OpHaCo/smart_coffee_machine/hardware/scope_capture/brew_button_press_falling_edge.png

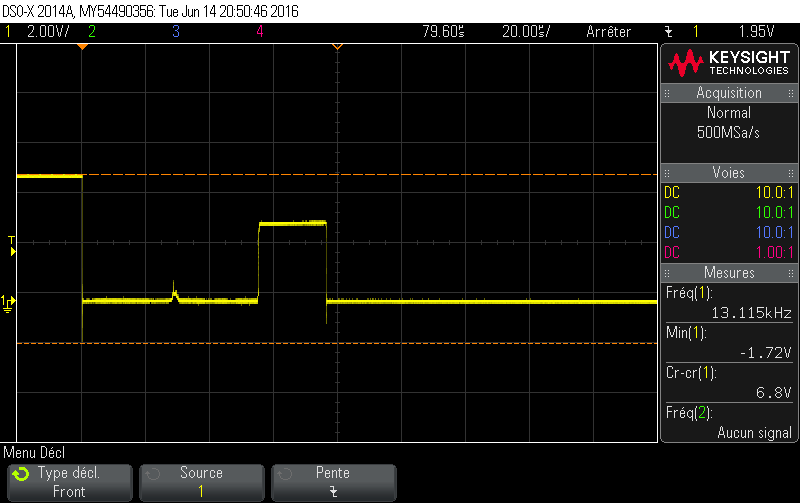
hardware/scope_capture/brew_button_press_falling_edge.png
