OpHaCo/smart_coffee_machine/hardware/scope_capture/brew_button_press_full.png

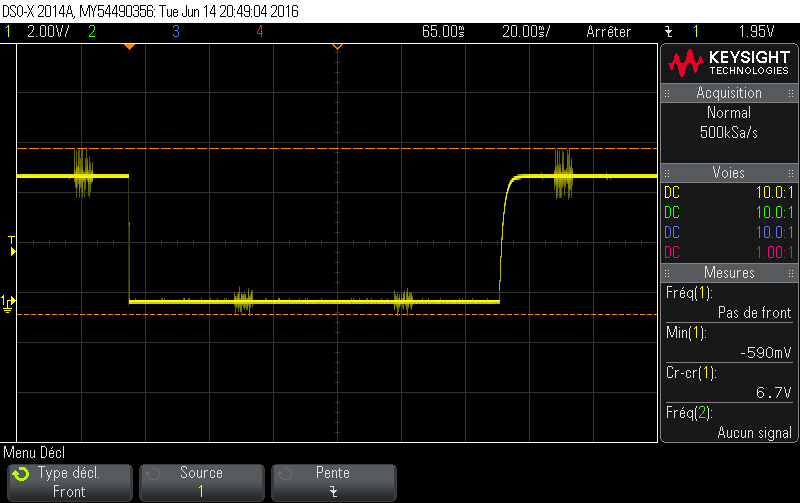
hardware/scope_capture/brew_button_press_full.png
