OpHaCo/smart_coffee_machine/hardware/scope_capture/small_cup_press_full.png

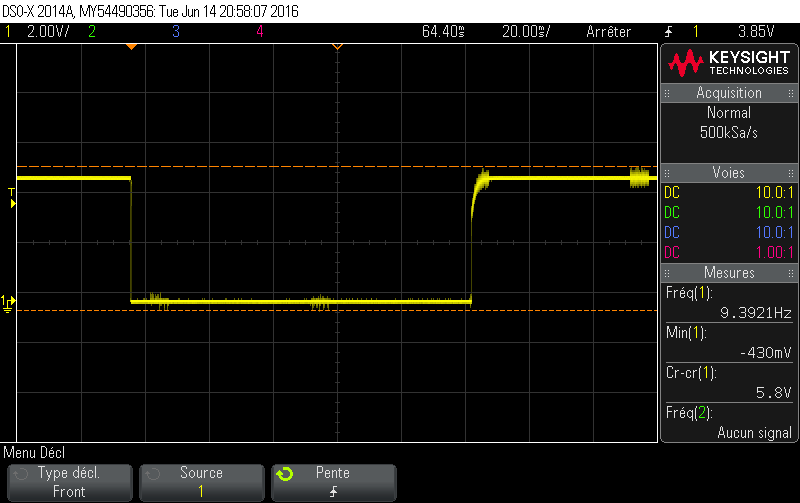
hardware/scope_capture/small_cup_press_full.png
