OpHaCo/smart_coffee_machine/hardware/scope_capture/small_cup_press_rising_edge.png

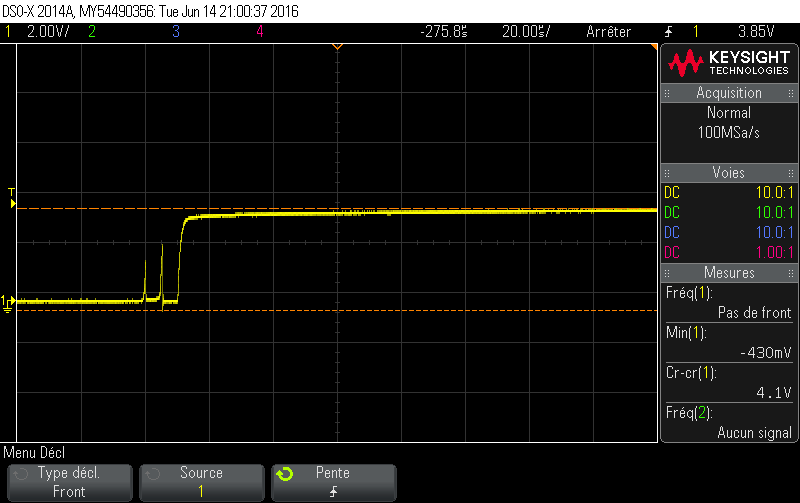
hardware/scope_capture/small_cup_press_rising_edge.png
