OpHaCo/smart_coffee_machine/img/front_panel_daughter_board.jpg

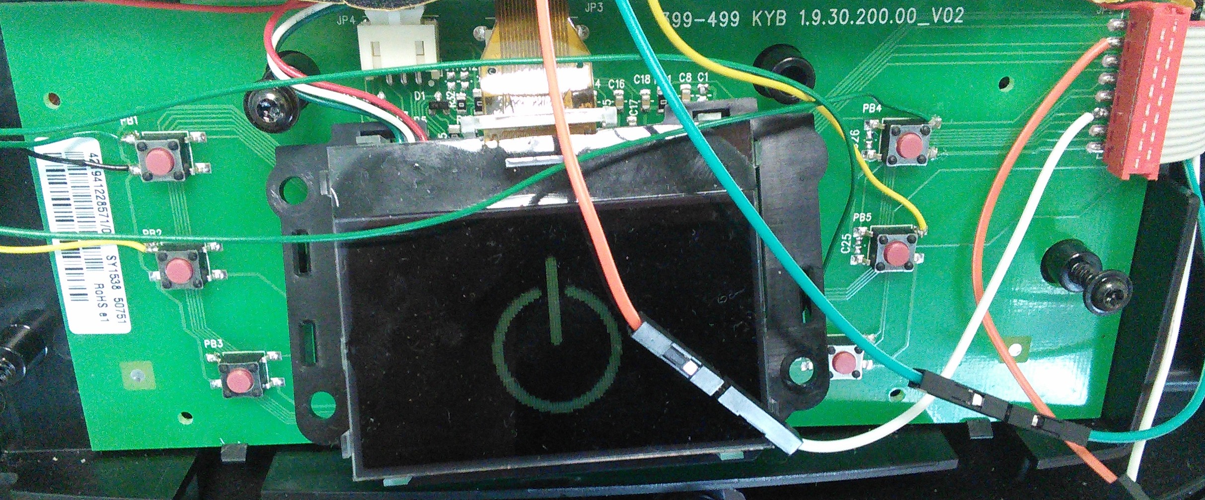
img/front_panel_daughter_board.jpg
