OpHaCo/smart_coffee_machine/img/saeco.jpg

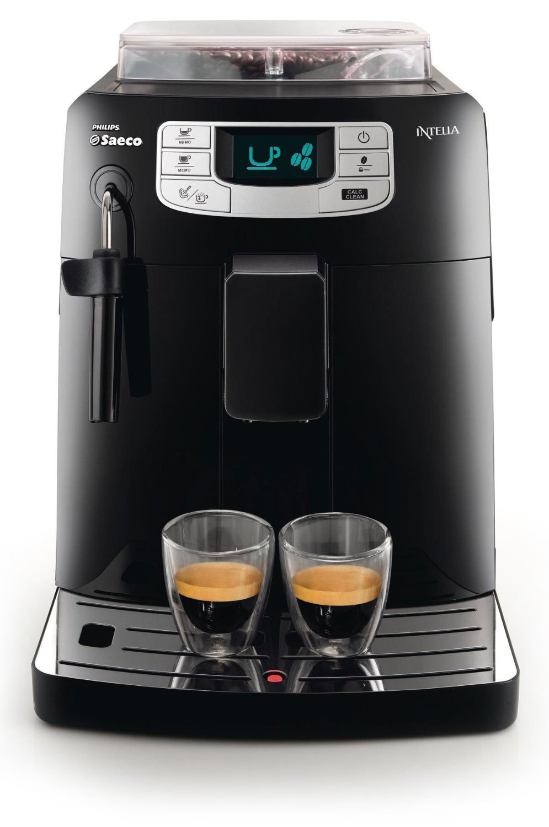
img/saeco.jpg
