OpHaCo/smart_coffee_machine/hardware/pcb_design/smart_coffee_hack.kicad_pcb

## KiCad design hardware/pcb_design/smart_coffee_hack.kicad_pcb (2016-07-22)

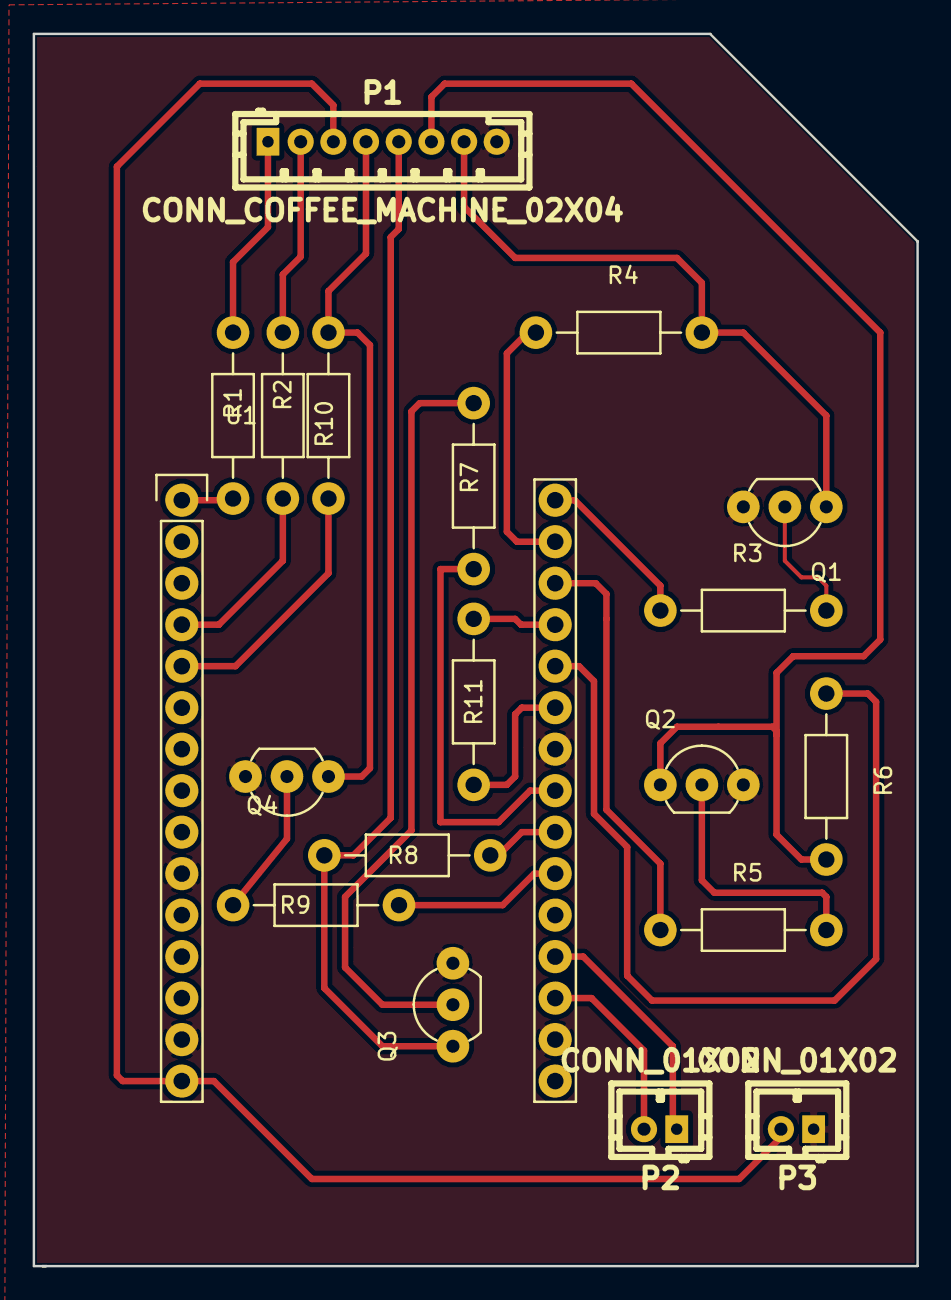
[picture p25: board smart_coffee_hack.kicad_pcb from above]

Board: 2 copper layers, 54.1 x 75.4 mm, 19 parts (0 on the bottom side), 26 nets.

Parts:
P1: CONN_COFFEE_MACHINE_02X04; b8b-ph-kl
P2, P3: CONN_01X02; b2b-ph-kl
Q1, Q2, Q3, Q4: BC547; TO-92_Inline_Wide
R1, R2, R3, R4, R5, R6, R7, R8, R9, R10, R11: R; Resistor_Horizontal_RM10mm
U1: NodeMCU_Amica_R2

Connections:
+3V3: R11.1, U1.16, U1.25
+5V: P1.3, P3.2, U1.15
GND: P1.8, P3.1, Q1.3, Q2.3, Q3.3, Q4.3, U1.10, U1.14, U1.17, U1.24
unnamed: P1.1, R1.2
unnamed: P1.2, R2.2
unnamed: P1.4, Q4.1, R10.2
unnamed: P1.5, Q3.1, R8.2
unnamed: P1.6, Q2.1, R6.2
unnamed: P1.7, Q1.1, R4.2
unnamed: P2.1, U1.19
unnamed: P2.2, U1.18
unnamed: Q1.2, R3.2
unnamed: Q2.2, R5.2
unnamed: Q3.2, R7.2
unnamed: Q4.2, R9.2
unnamed: R1.1, U1.1
unnamed: R2.1, U1.4
unnamed: R3.1, U1.30
unnamed: R4.1, U1.29
unnamed: R5.1, U1.28
unnamed: R6.1, U1.26
unnamed: R7.1, U1.23
unnamed: R8.1, U1.22
unnamed: R9.1, U1.21
unnamed: R10.1, U1.5
unnamed: R11.2, U1.27
