OpHaCo/smart_coffee_machine/(commit log)

2016-06-02 debug on button callback
2016-06-14 Add some missing functions
    [saeco_intelia.c, saeco_intelia.h]
2016-06-14 Add last version of example from issue #3
    [saeco_hack_example.ino]
2016-06-14 bad topic for power
2016-06-14 Better button press detection
2016-06-14 Fix startup errors at startup after multiple MQTT client api calls
    [saeco_hack_example.ino]
2016-06-17 Squashed 'hardware/pcb_design/additional_components/stavros-kicad-components/' content from commit 888a47e
    git-subtree-dir: hardware/pcb_design/additional_components/stavros-kicad-components
    git-subtree-split: 888a47ec0d75921a9c1fc3e0a370f151ceb32d3c
2016-06-17 Add pcb schematic
    [smart_coffee_hack.kicad_pcb, smart_coffee_hack.sch]
2016-06-17 Add pcb
    [smart_coffee_hack.kicad_pcb, smart_coffee_hack.sch]
2016-06-24 Add draft of SPI slave COG display sniffer on teensy
2016-07-20 Add SPI display sniffer. Add LCD pattern detector to get status of saeco in saeco_status
2016-07-22 Update kicad component. Update doc.
2016-07-22 Status handling. Same name for button press / button simulation MQTT topics suffixes
2016-07-22 PCB modification
    [smart_coffee_hack.kicad_pcb, smart_coffee_hack.sch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]
2016-07-26 Update example according to PCB
2016-08-02 Add detection over frame. Detection depends on face detected size
2016-08-02 Make script runnable on raspberry
2016-08-30 Use openhab to display last button press date
2016-08-30 Capture in a separate thread. Dynamically add training imgs for face recognition
2016-08-31 Capture training frame using MQTT
2016-09-07 Add hello message on power on
2016-09-16 Add donald. bug in PowerOn/Off sound
2016-10-06 Capture - Detect thread synchro using double buffering
2016-10-06 Do not power machine if user do not take any coffee. Missing map file
2016-11-08 Coffee machine offers a wireless access point
2017-01-25 Minor updates. Exit on capture thread exit bug because of isAlive typo
    [detect_smile.py]
2017-10-20 Power on machine on face detection. Get status on openhab start
