OpHaCo/smart_coffee_machine/(notices)

Notices in the files:
gateway_software/examples/CafeSourire/detect_smile.py:
it under the terms of the GNU General Public License as published by
